hatanoh/n40a8-pcb/script/README.md

# conv.awk
## 説明
KiCadの製造用出力で出力された部品配置ファイルから、スイッチのソケットなど、フットプリントの位置とパーツの位置がオフセットしているパーツを修正して、JLEPCB PCBA向けCPLファイルを出力する。

## 使い方
awk -f conv.awk <keyboard>-all.pos > positions.csv

## 設定
新しいパーツが増えた場合はフットプリント中心からのオフセットx,y,角度を連想配列offsetに値(Value)をキーとして追加する。

例) 本キーボードで使用しているCPG151101S11フットプリントでソケットは中心から(-0.635, 3.81)オフセットしているため下記の様に記述している
``` awk
BEGIN {
    (snip)
	# parts offset
	offset["CPG151101S11-16"]="-0.635,3.81,0"
	offset["TPS61221"]="0,0,90"
    (snip)
}
```
