hatanoh/n40a8-pcb/n42a7c/BOM.md

# パーツリスト
|#|名称|メーカー|型番|個数|メモ|
|--|--|--|--|--|--|
|1|ソケット |Keil |CPG151101S11|42  |実装済|
|2|ダイオード |各社 |1N4148W|58  |実装済|
|3|プッシュスイッチ |alps |SKTDLDE010|2 |実装済|
|4|スライドスイッチ |alps |SSSS811101|1 |実装済|
|5|コネクタ |JST |S2B-PH-K-S|1 |添付|
|6|防振ワッシャ(M3D6t1)|廣杉 |HAW-0306-10|4 |添付|
|7|スペーサー(M3L7) |廣杉 |ARU-307|4 |添付|
|8|ネジ(M3L5) |日東精工 |ULA-0305|8 |添付|
|9|ゴム足(前)|3M|バンポン SJ5702 φ7.9mm/h2.2mm|4|添付|
|10|ゴム足(後)|3M|バンポン SJ5027 φ16mm/h7.9mm|2|添付|
|11-1|ドーターボード |seeedstudio |XIAO nRF52840 |1|各自入手のこと。11-2とどちらか選択|
|11-2|ドーターボード |seeedstudio |XIAO RP2040 |(1)|各自入手のこと。11-1とどちらか選択|
|12|スタビライザ(2U)|各社|各種|4|各自入手のこと|
|13|バッテリ|各社|厚さ～7mm/1450,1535,1634,1730など/充電電流100mA～|1|11-2を選択した場合不要。各自入手のこと。例 [せんごく DTP401525(PHR)](https://www.sengoku.co.jp/mod/sgk_cart/detail.php?code=EEHD-53KN)|
|14|キーキャップ|各社|各種||60%向けキーキャップ/2.25u,2uスペース,40%向けの特殊なキーキャップは必要ありません|
