hatanoh/n40a8-pcb/n42a7c/n42a7c.kicad_pcb

## KiCad design n42a7c/n42a7c.kicad_pcb (2025-07-18)

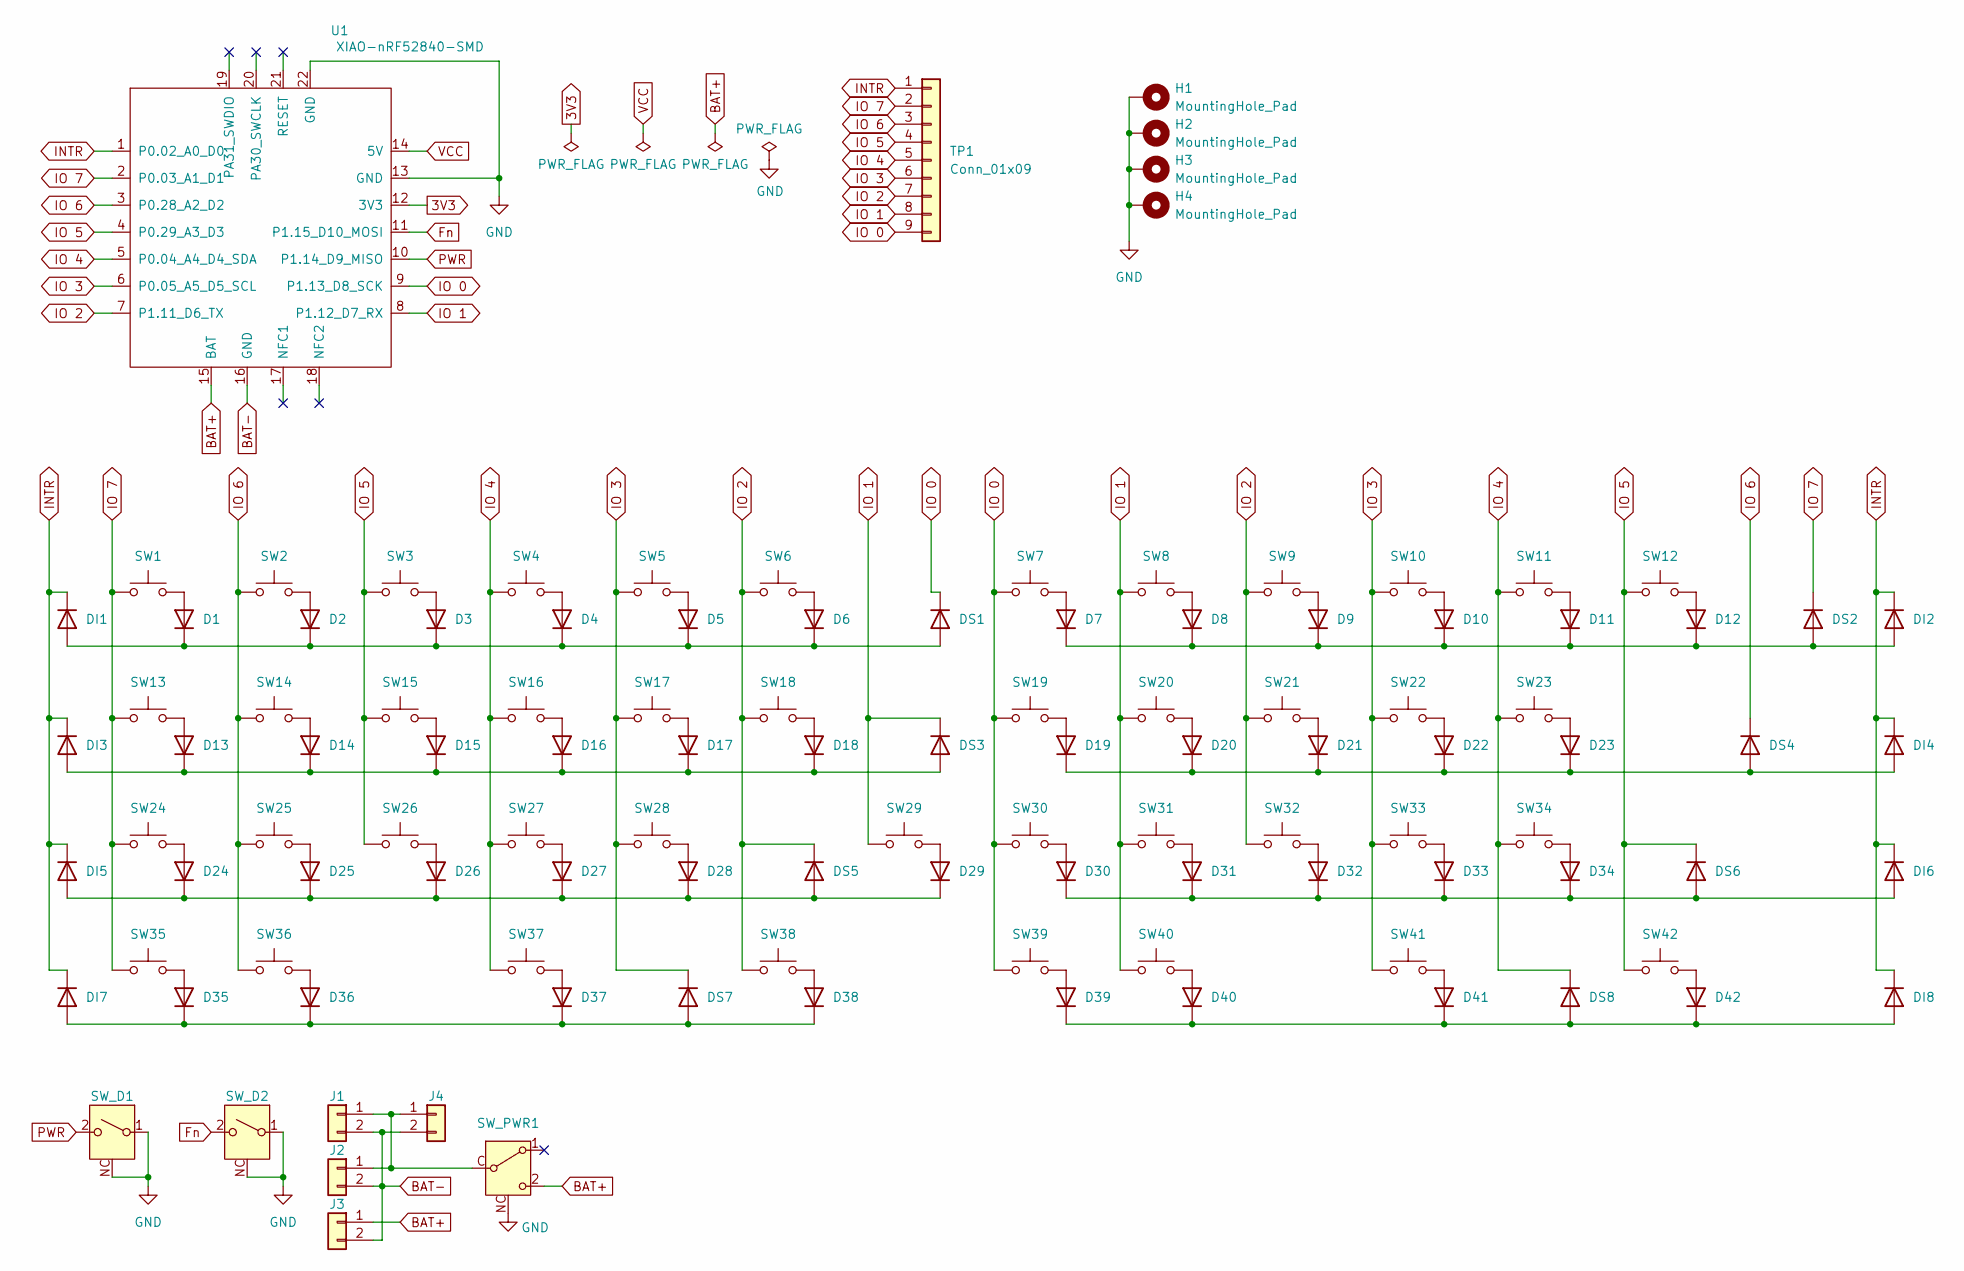
[picture p1: schematic n42a7c.kicad_sch, n40a8c]

Parts:
D1, D2, D3, D4, D5, D6, D7, D8, D9, D10, D11, D12, D13, D14, D15, D16, D17, D18, D19, D20, D21, D22, D23, D24, D25, D26, D27, D28, D29, D30, D31, D32, D33, D34, D35, D36, D37, D38, D39, D40, D41, D42: 1N4148W; D_SOD-123
DI1, DI2, DI3, DI4, DI5, DI6, DI7, DI8: 1N4148W; D_SOD-123
DS1, DS2, DS3, DS4, DS5, DS6, DS7, DS8: 1N4148W; D_SOD-123
H1, H2, H3, H4: MountingHole_Pad; MountingHole_M3_plating_truss
J1: S2B-PH-SM4-TB; JST_PH_S2B-PH-SM4-TB_1x02-1MP_P2.00mm_Horizontal
J2, J3: PinHeader_1x02_P2.00mm_Vertical
J4: S2B-PH-K; JST_PH_S2B-PH-K_1x02_P2.00mm_Horizontal
SW1, SW12: CPG151101S11-16; CPG151101S11_1.5u
SW2, SW3, SW4, SW5, SW6, SW7, SW8, SW9, SW10, SW11, SW14, SW15, SW16, SW17, SW18, SW19, SW20, SW21, SW22, SW25, SW26, SW27, SW28, SW29, SW30, SW31, SW32, SW33: CPG151101S11-16; CPG151101S11_1u
SW13, SW34: CPG151101S11-16; CPG151101S11_1.75u
SW23, SW24, SW39: CPG151101S11-16; CPG151101S11_2.25u
SW35, SW36, SW37, SW40, SW41, SW42: CPG151101S11-16; CPG151101S11_1.25u
SW38: CPG151101S11-16; CPG151101S11_2u
SW_D1, SW_D2: SKTDLDE010
SW_PWR1: SSSS811101
TP1: Conn_01x09; PinHeader_1x09_P1.27mm_Conthrough
U1: XIAO-nRF52840-SMD; XIAO-nRF52840-DIP2

Connections:
3V3: U1.12 (3V3)
BAT+: J3.1, SW_PWR1.2 (C), U1.15 (BAT)
BAT-: J1.2, J2.2, J3.2, J4.2, U1.16 (GND)
Fn: SW_D2.2 (B), U1.11 (P1.15_D10_MOSI)
GND: H1.1, H2.1, H3.1, H4.1, SW_D1.1 (A), SW_D1.NC, SW_D2.1 (A), SW_D2.NC, SW_PWR1.NC, U1.13 (GND), U1.22 (GND)
INTR: DI1.1 (K), DI2.1 (K), DI3.1 (K), DI4.1 (K), DI5.1 (K), DI6.1 (K), DI7.1 (K), DI8.1 (K), TP1.1, U1.1 (P0.02_A0_D0)
IO 0: DS1.1 (K), SW7.1, SW19.1, SW30.1, SW39.1, TP1.9, U1.9 (P1.13_D8_SCK)
IO 1: DS3.1 (K), SW8.1, SW20.1, SW29.1, SW31.1, SW40.1, TP1.8, U1.8 (P1.12_D7_RX)
IO 2: DS5.1 (K), SW6.1, SW9.1, SW18.1, SW21.1, SW32.1, SW38.1, TP1.7, U1.7 (P1.11_D6_TX)
IO 3: DS7.1 (K), SW5.1, SW10.1, SW17.1, SW22.1, SW28.1, SW33.1, SW41.1, TP1.6, U1.6 (P0.05_A5_D5_SCL)
IO 4: DS8.1 (K), SW4.1, SW11.1, SW16.1, SW23.1, SW27.1, SW34.1, SW37.1, TP1.5, U1.5 (P0.04_A4_D4_SDA)
IO 5: DS6.1 (K), SW3.1, SW12.1, SW15.1, SW26.1, SW42.1, TP1.4, U1.4 (P0.29_A3_D3)
IO 6: DS4.1 (K), SW2.1, SW14.1, SW25.1, SW36.1, TP1.3, U1.3 (P0.28_A2_D2)
IO 7: DS2.1 (K), SW1.1, SW13.1, SW24.1, SW35.1, TP1.2, U1.2 (P0.03_A1_D1)
unnamed: D1.2 (A), SW1.2
unnamed: D1.1 (K), D2.1 (K), D3.1 (K), D4.1 (K), D5.1 (K), D6.1 (K), DI1.2 (A), DS1.2 (A)
unnamed: D2.2 (A), SW2.2
unnamed: D3.2 (A), SW3.2
unnamed: D4.2 (A), SW4.2
unnamed: D5.2 (A), SW5.2
unnamed: D6.2 (A), SW6.2
unnamed: D7.2 (A), SW7.2
unnamed: D8.2 (A), SW8.2
unnamed: D9.2 (A), SW9.2
unnamed: D10.2 (A), SW10.2
unnamed: D7.1 (K), D8.1 (K), D9.1 (K), D10.1 (K), D11.1 (K), D12.1 (K), DI2.2 (A), DS2.2 (A)
unnamed: D11.2 (A), SW11.2
unnamed: D12.2 (A), SW12.2
unnamed: D13.2 (A), SW13.2
unnamed: D13.1 (K), D14.1 (K), D15.1 (K), D16.1 (K), D17.1 (K), D18.1 (K), DI3.2 (A), DS3.2 (A)
unnamed: D14.2 (A), SW14.2
unnamed: D15.2 (A), SW15.2
unnamed: D16.2 (A), SW16.2
unnamed: D17.2 (A), SW17.2
unnamed: D18.2 (A), SW18.2
unnamed: D19.2 (A), SW19.2
unnamed: D19.1 (K), D20.1 (K), D21.1 (K), D22.1 (K), D23.1 (K), DI4.2 (A), DS4.2 (A)
unnamed: D20.2 (A), SW20.2
unnamed: D21.2 (A), SW21.2
unnamed: D22.2 (A), SW22.2
unnamed: D23.2 (A), SW23.2
unnamed: D24.2 (A), SW24.2
unnamed: D24.1 (K), D25.1 (K), D26.1 (K), D27.1 (K), D28.1 (K), D29.1 (K), DI5.2 (A), DS5.2 (A)
unnamed: D25.2 (A), SW25.2
unnamed: D26.2 (A), SW26.2
unnamed: D27.2 (A), SW27.2
unnamed: D28.2 (A), SW28.2
unnamed: D29.2 (A), SW29.2
unnamed: D30.2 (A), SW30.2
unnamed: D30.1 (K), D31.1 (K), D32.1 (K), D33.1 (K), D34.1 (K), DI6.2 (A), DS6.2 (A)
unnamed: D31.2 (A), SW31.2
unnamed: D32.2 (A), SW32.2
unnamed: D33.2 (A), SW33.2
unnamed: D34.2 (A), SW34.2
unnamed: D35.2 (A), SW35.2
unnamed: D35.1 (K), D36.1 (K), D37.1 (K), D38.1 (K), DI7.2 (A), DS7.2 (A)
unnamed: D36.2 (A), SW36.2
unnamed: D37.2 (A), SW37.2
unnamed: D38.2 (A), SW38.2
unnamed: D39.2 (A), SW39.2
unnamed: D39.1 (K), D40.1 (K), D41.1 (K), D42.1 (K), DI8.2 (A), DS8.2 (A)
unnamed: D40.2 (A), SW40.2
unnamed: D41.2 (A), SW41.2
unnamed: D42.2 (A), SW42.2
unnamed: J1.1, J2.1, J4.1, SW_PWR1.C (B)
PWR: SW_D1.2 (B), U1.10 (P1.14_D9_MISO)
VCC: U1.14 (5V)

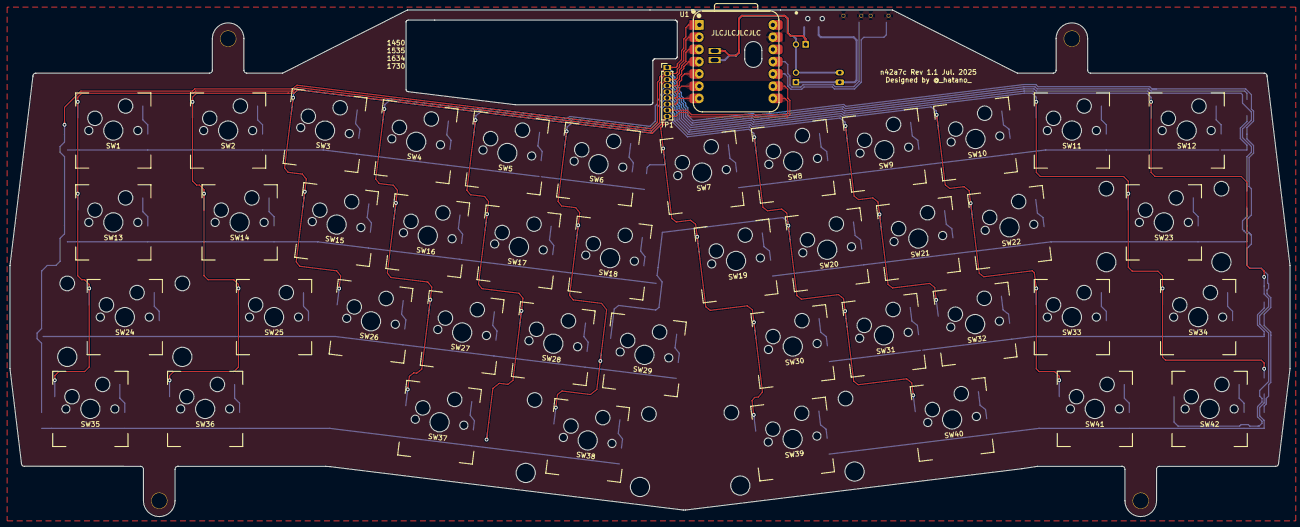
[picture p2: board n42a7c.kicad_pcb from above]

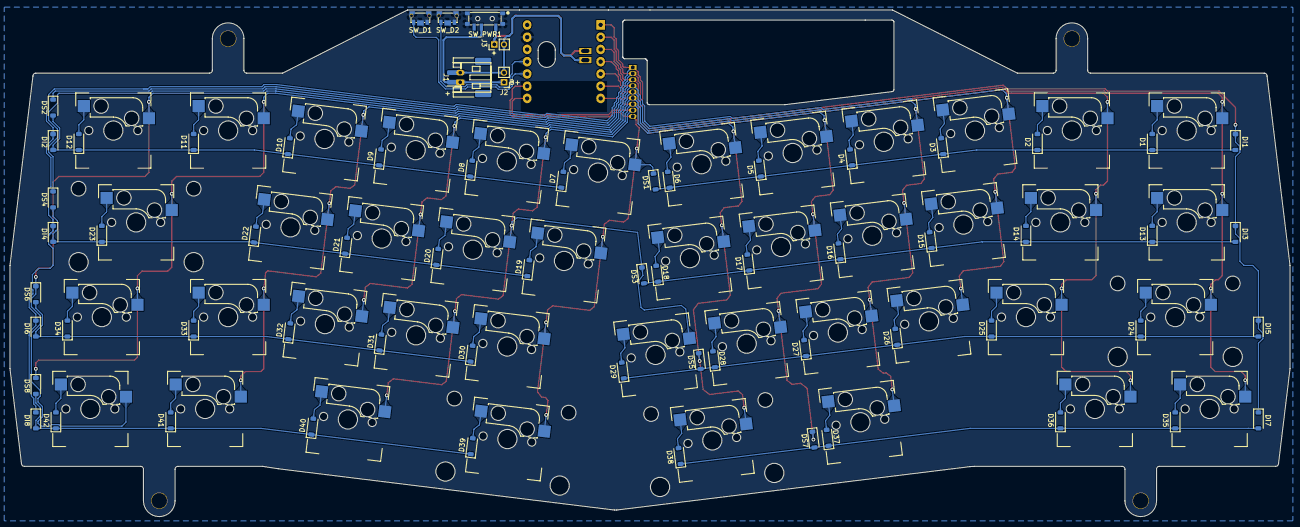
[picture p3: board n42a7c.kicad_pcb from below]

Board: 2 copper layers, 265.5 x 105.1 mm, 113 parts (107 on the bottom side), 65 nets.
