hatanoh/n40a8-pcb/n42a7c/buildguide.md

# ドーターボードの取り付け
1. XIAOドーターボードを以下のいずれかの方法で取り付ける
- 側面スルーホールを使って基板に直付けで半田付けする。バッテリはフラックスを塗りスルーホールに半田を流し込むことによって接続する。
- ピンヘッダ/コンスルーヘッダ(パーツリスト外)で接続する。バッテリはリード線(パーツリスト外)を半田付けし基板穴を通して裏側に通したあと後J3のpin1(BAT+)/pin2(BAT-)に半田付けする
# キーボードの組み立て
1. バッテリをボトムプレートに貼り付ける
- ボトムプレートと回路基板を重ねる  
- 回路基板の穴の位置でバッテリを位置決めし両面テープ(パーツリスト外)で貼り付ける/がたついても良いのであれば貼り付けなくても良い
- 回路基板を外す
2. 回路基板にスタビライザを取り付ける
- SW23,24,38,39に取り付ける
3. トッププレートと回路基板を重ねる
- ドーターボードをヘッダ経由で接続した場合、トッププレートとドーターが干渉する場合はトッププレートを削って調整する。
4. スイッチを取り付ける
- 四隅から取り付けると良い
5. バッテリ以下のいずれかの方法で接続する
- バッテリにJST PH2pinコネクタが取り付けられている場合は基板裏側J1にコネクタを半田付けし、J1に接続する。pin1が+なのでもし逆に配線されている場合はコンタクトを外して取り替える。
- バッテリにコネクタが取り付けられていない場合は、J2のpin1(+)/pin2(-)に直接半田付けする。
- 回路基板の穴にバッテリを納める
6. ボトムプレートにスペーサーを取り付ける
- 裏側からスペーサーをネジ止めする
7. ボトムプレートの取り付け取り付ける
- トッププレート/回路基板にネジを差し込み、ワッシャを入れる
- ボトムプレートを重ねる。回路基板のバッテリコネクタがボトムプレートの穴に逃げるのを確認する。
- ネジ止めする。ネジは「程良く」締め付ける。
8. ゴム足を取り付ける
- 前側に小さいゴム足を取り付ける
- 後側にゴム足を貼り付ける。傾斜させるなら大きい方。させないなら小さい方を貼り付ける。
9. キーキャップを取り付ける
