hatanoh/n40a8-pcb/(commit log)

2025-05-08 Initial commit.
    [n40a8.kicad_pcb, n40a8.kicad_sch, n40a8c.kicad_pcb, n40a8c.kicad_sch]
2025-05-08 revise wiring
    [n40a8.kicad_pcb]
2025-05-08 cosmetic change
    [n40a8c.kicad_sch]
2025-05-22 M2→M2.6
    [n40a8c.kicad_pcb, n40a8c.kicad_sch]
2025-05-26 M2.6→M3
    [n40a8c.kicad_pcb, n40a8c.kicad_sch]
2025-06-05 revice tab
    [n40a8c.kicad_pcb]
2025-06-06 revise tab
    [n40a8c.kicad_pcb]
2025-06-06 create production data
    [n40a8c_bottom.kicad_pcb, n40a8c_pcb.kicad_pcb, n40a8c_top.kicad_pcb]
2025-06-06 comply design rule (JLCPCB)
    [n40a8c.kicad_pcb]
2025-06-08 revise keysocket footprint. revise production pcb data.
    [n40a8c_bottom.kicad_pcb, n40a8c_pcb.kicad_pcb, n40a8c_top.kicad_pcb]
2025-06-08 add n42a7c valiant.
    [n42a7c.kicad_pcb, n42a7c.kicad_sch]
2025-06-09 revise n42a7c
    [n42a7c.kicad_pcb]
2025-06-10 add production files
    [n42a7c.kicad_pcb, n42a7c_b.kicad_pcb, n42a7c_p.kicad_pcb, n42a7c_t.kicad_pcb]
2025-06-11 revise SSAJ1x0100 footprint / symbol
    [n42a7c.kicad_pcb, n42a7c.kicad_sch]
2025-06-11 remove work
    [n40a8c_bottom.kicad_pcb, n40a8c_pcb.kicad_pcb, n40a8c_top.kicad_pcb, n42a7c_b.kicad_pcb, n42a7c_p.kicad_pcb, n42a7c_t.kicad_pcb]
2025-06-12 revise power switch
    [n42a7c.kicad_pcb]
2025-06-16 revise switch pos.
    [n42a7c.kicad_pcb]
2025-06-16 revise power connector
    [n42a7c.kicad_pcb, n42a7c.kicad_sch]
2025-06-17 revise power SW
    [n42a7c.kicad_pcb, n42a7c.kicad_sch]
2025-06-19 revise switch
    [n42a7c.kicad_pcb, n42a7c.kicad_sch]
2025-06-20 revise switch symbol/footprint
    [n42a7c.kicad_pcb, n42a7c.kicad_sch]
2025-06-21 create plate
    [n42a7c.kicad_sch, n42a7c_b.kicad_pcb, n42a7c_p.kicad_pcb, n42a7c_t.kicad_pcb]
2025-06-21 revise edge.cut
    [n42a7c.kicad_pcb]
2025-06-24 revise power line
    [n42a7c.kicad_pcb, n42a7c.kicad_sch]
2025-06-25 revise sw
    [n42a7c.kicad_pcb]
2025-06-26 revise 3dmodel path
    [n42a7c.kicad_pcb]
2025-06-26 revise 3dshape path
    [n42a7c.kicad_pcb]
2025-06-30 correct foots
    [n42a7c.kicad_pcb, n42a7c.kicad_sch, n42a7c_p.kicad_pcb]
2025-06-30 create plate / production PCB
    [n42a7c_b.kicad_pcb, n42a7c_p.kicad_pcb, n42a7c_t.kicad_pcb]
2025-06-30 revise power conn
    [n42a7c.kicad_pcb, n42a7c.kicad_sch]
2025-06-30 remove n40a8c
    [n40a8c.kicad_pcb, n40a8c.kicad_sch]
2025-07-01 revise keylayout
    [n42a7c.kicad_pcb]
2025-07-02 create plate/production PCB
    [n42a7c.kicad_pcb, n42a7c_b.kicad_pcb, n42a7c_p.kicad_pcb, n42a7c_t.kicad_pcb]
2025-07-02 create production plate
    [n42a7c_b.kicad_pcb, n42a7c_t.kicad_pcb]
2025-07-06 revise wire
    [n42a7c.kicad_pcb]
2025-07-18 regen production pcb data
    [n42a7c.kicad_pcb, n42a7c_b.kicad_pcb, n42a7c_p.kicad_pcb, n42a7c_t.kicad_pcb]
